SpaceTeam/STS1_EDU_Hardware/README.md

# STS1_EDU_Hardware
 Contains all Hardware Informations from EDU 2.6 onwards
