SpaceTeam/STS1_EDU_Hardware/STS1_EDU_V2_7/STS1_EDU_V2_7.kicad_pcb

## KiCad design STS1_EDU_V2_7/STS1_EDU_V2_7.kicad_pcb (2024-02-10)

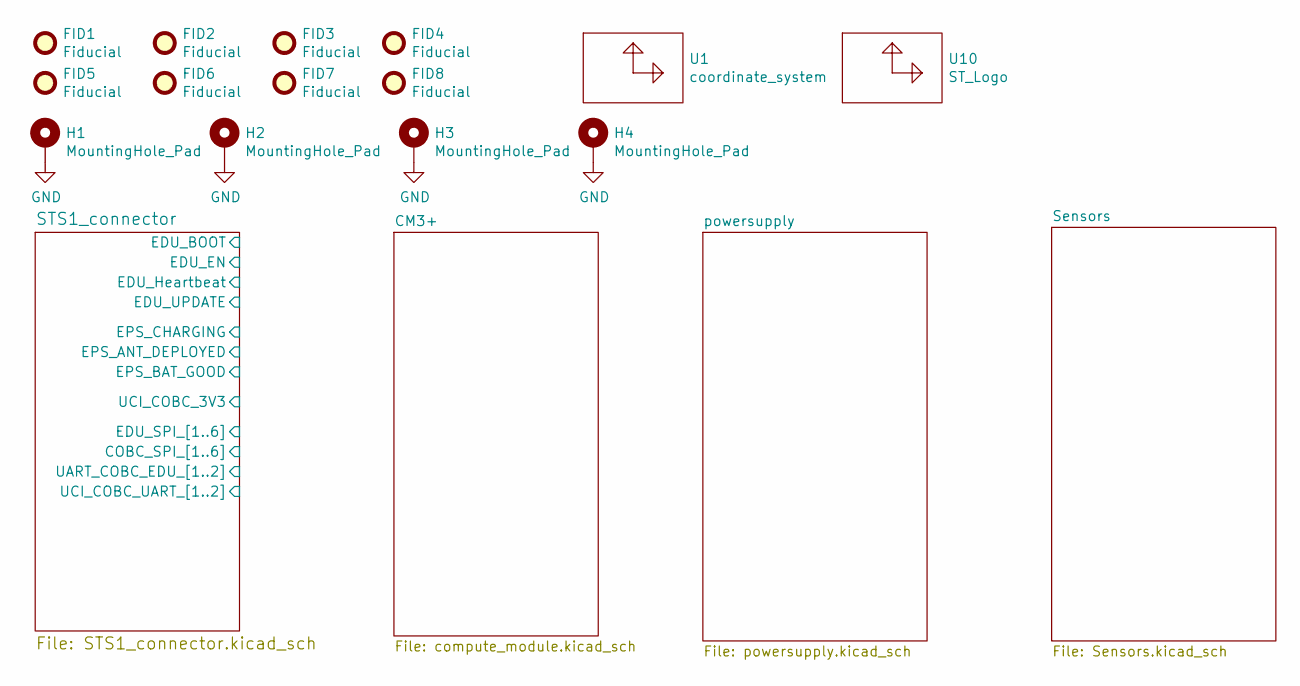
[picture p1: schematic STS1_EDU_V2_7.kicad_sch, STS1 template]

Parts:
FID1, FID2, FID3, FID4, FID5, FID6, FID7, FID8: Fiducial; Fiducial_0.75mm_Mask1.5mm
H1, H2, H3, H4: MountingHole_Pad; MountingHole_4.3mm_M4_Pad_Via
U1: coordinate_system; Coordinates
U10: ST_Logo; STLogo_7x8

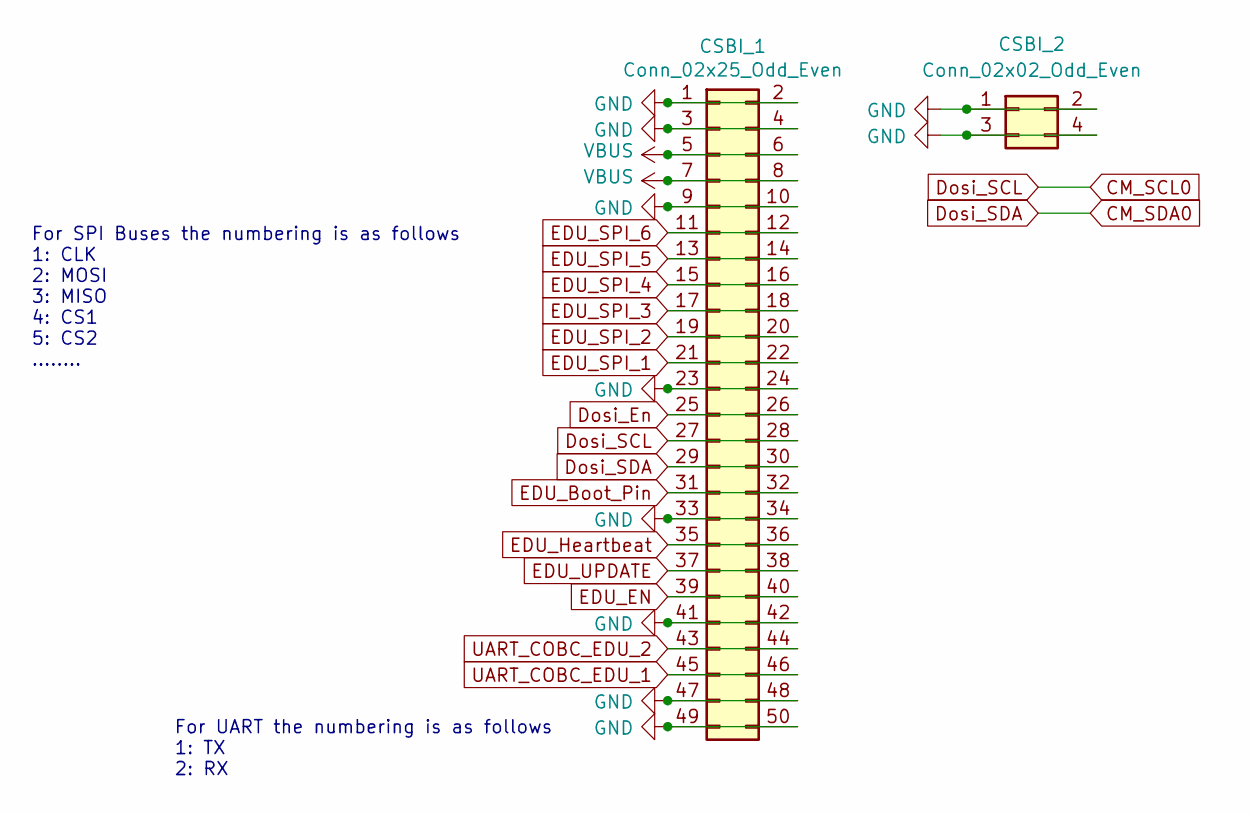
[picture p2: schematic STS1_connector.kicad_sch, STS1_connectors]

Parts:
CSBI_1: Conn_02x25_Odd_Even; PinHeader_2x25_P2.00mm_Vertical
CSBI_2: Conn_02x02_Odd_Even; PinHeader_2x02_P2.00mm_Vertical

Connections:
CM_SCL0: CSBI_1.27, CSBI_1.28; also elsewhere on the board
CM_SDA0: CSBI_1.29, CSBI_1.30; also elsewhere on the board
Dosi_En: CSBI_1.25, CSBI_1.26; also elsewhere on the board
EDU_Boot_Pin: CSBI_1.31, CSBI_1.32; also elsewhere on the board
EDU_EN: CSBI_1.39, CSBI_1.40; also elsewhere on the board
EDU_Heartbeat: CSBI_1.35, CSBI_1.36; also elsewhere on the board
EDU_SPI_1: CSBI_1.21, CSBI_1.22; also elsewhere on the board
EDU_SPI_2: CSBI_1.19, CSBI_1.20; also elsewhere on the board
EDU_SPI_3: CSBI_1.17, CSBI_1.18; also elsewhere on the board
EDU_SPI_4: CSBI_1.15, CSBI_1.16; also elsewhere on the board
EDU_SPI_5: CSBI_1.13, CSBI_1.14; also elsewhere on the board
EDU_SPI_6: CSBI_1.11, CSBI_1.12; also elsewhere on the board
EDU_UPDATE: CSBI_1.37, CSBI_1.38; also elsewhere on the board
UART_COBC_EDU_1: CSBI_1.45, CSBI_1.46
UART_COBC_EDU_2: CSBI_1.43, CSBI_1.44
VBUS: CSBI_1.5, CSBI_1.6, CSBI_1.7, CSBI_1.8; also elsewhere on the board

Notes on the sheet:
For SPI Buses the numbering is as follows 1: CLK 2: MOSI 3: MISO 4: CS1 5: CS2 ........
For UART the numbering is as follows 1: TX 2: RX

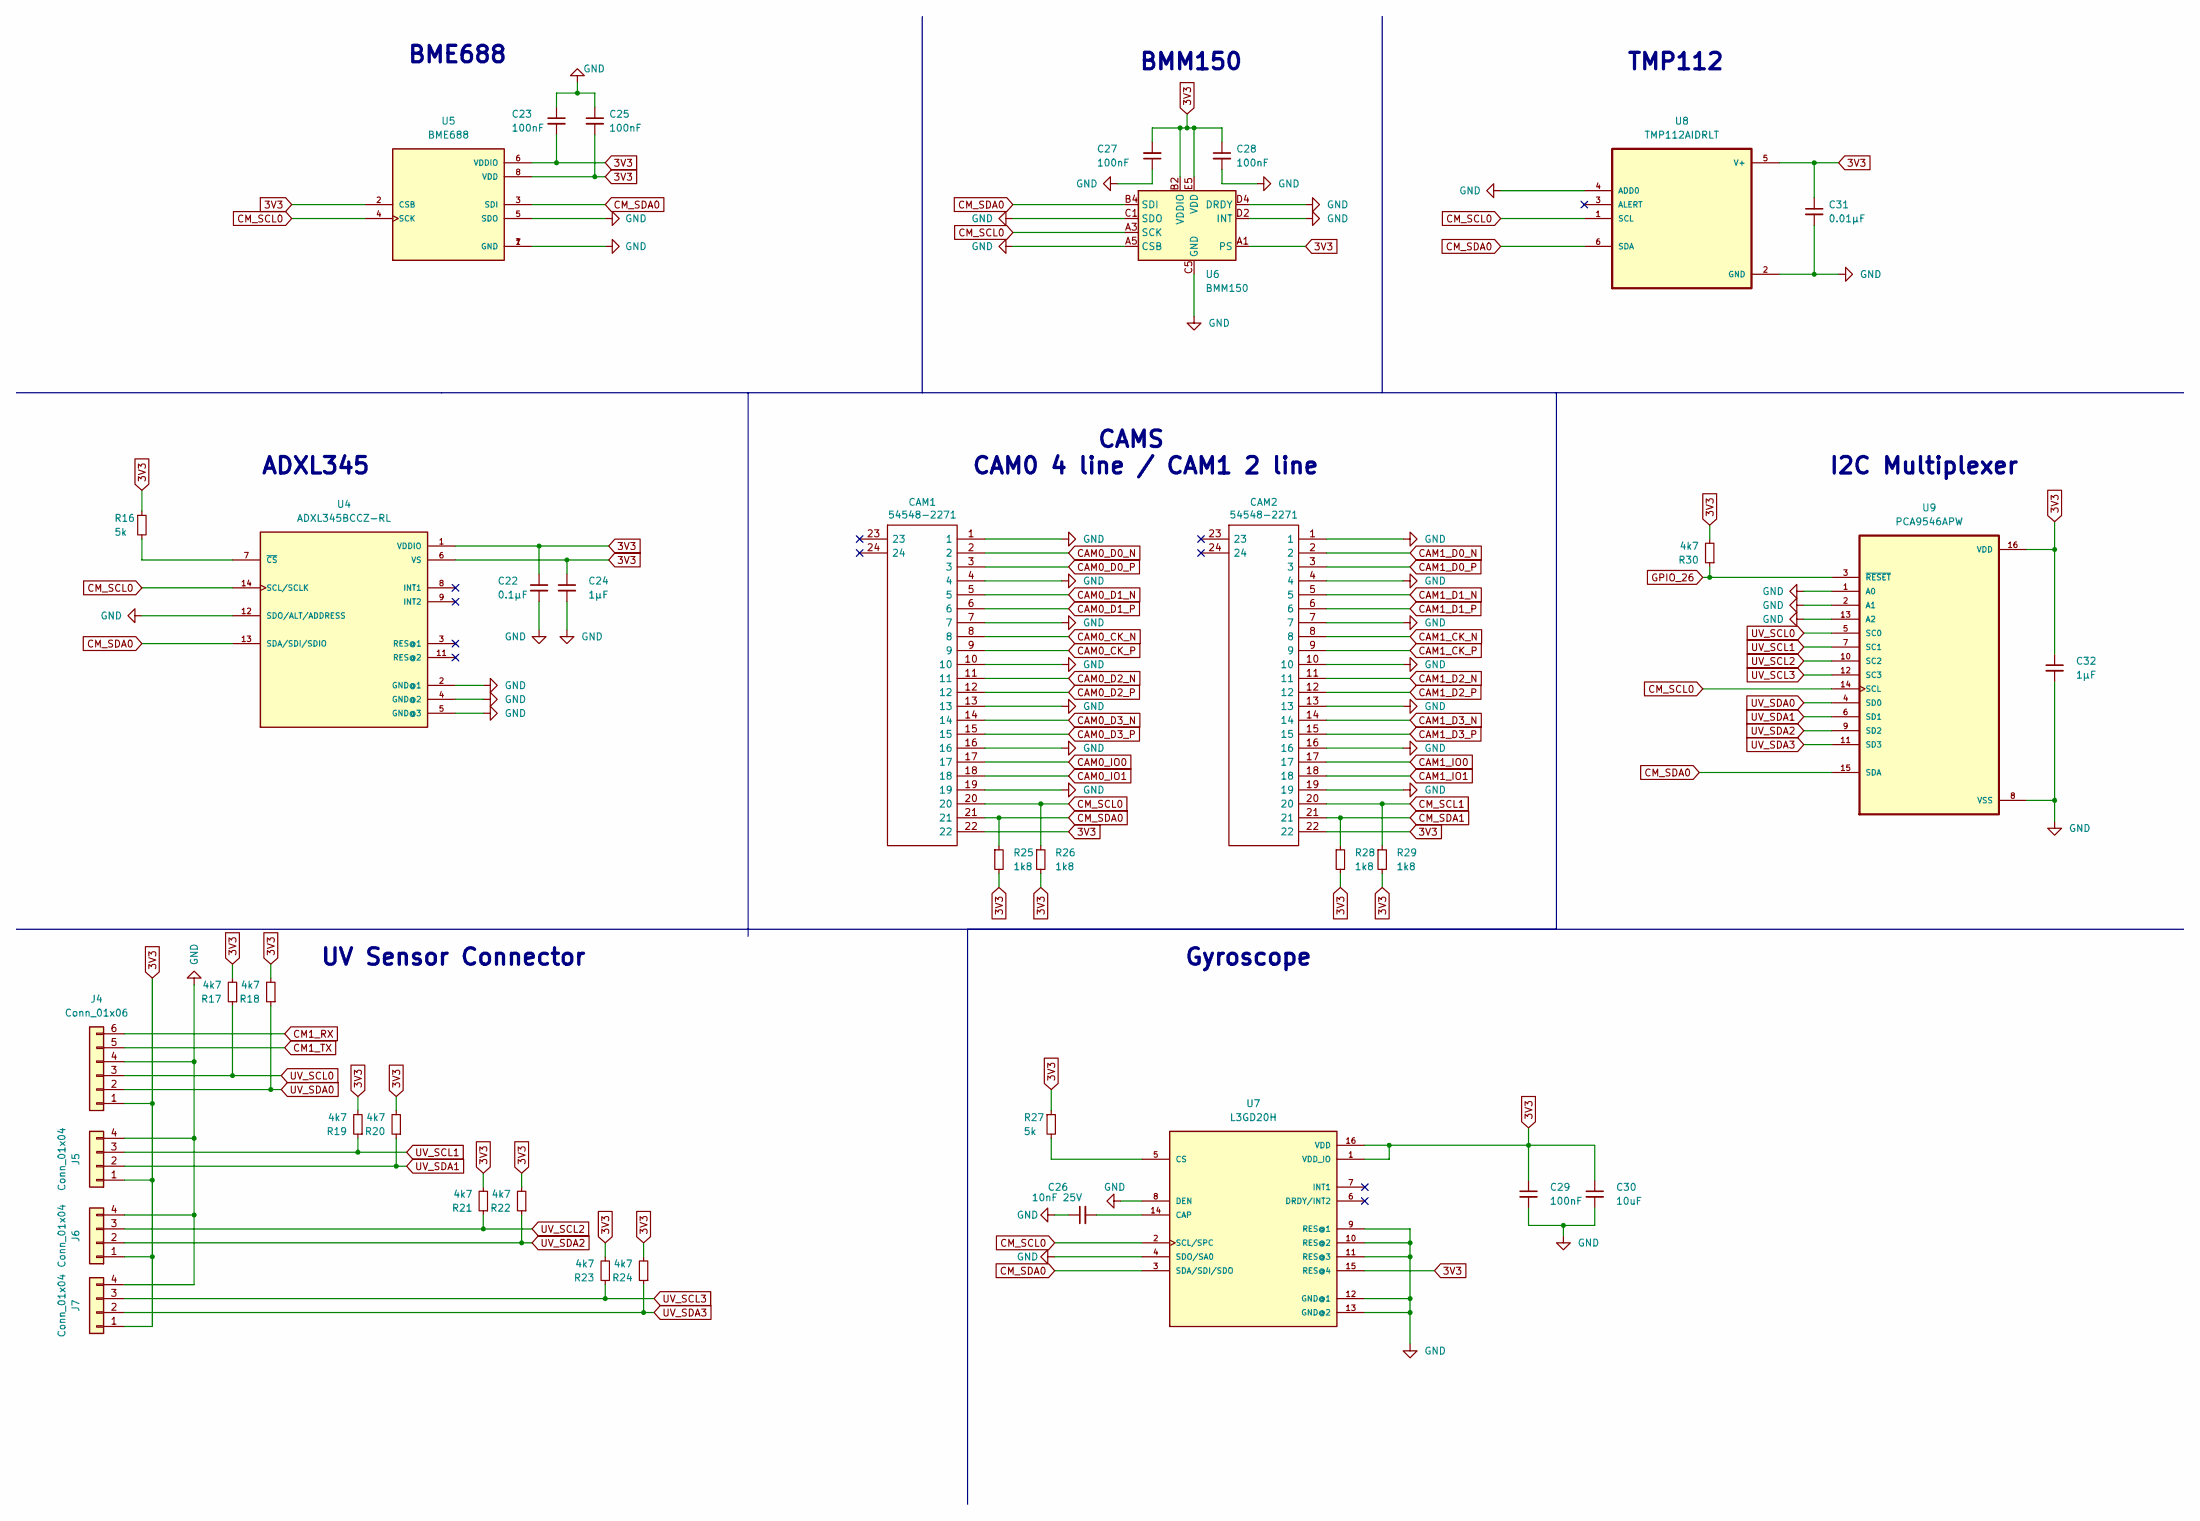
[picture p3: schematic Sensors.kicad_sch]

Parts:
C22: 0.1µF; C_0603_1608Metric_Pad1.08x0.95mm_HandSolder
C23, C25, C27, C28, C29: 100nF; C_0603_1608Metric_Pad1.08x0.95mm_HandSolder
C24, C32: 1µF; C_0603_1608Metric_Pad1.08x0.95mm_HandSolder
C26: 10nF 25V; C_0603_1608Metric_Pad1.08x0.95mm_HandSolder
C30: 10uF; C_0603_1608Metric_Pad1.08x0.95mm_HandSolder
C31: 0.01µF; C_0603_1608Metric_Pad1.08x0.95mm_HandSolder
CAM1, CAM2: 54548-2271; 545482271; Manufacturer_Part_Number 54548-2271; Mouser Part Number 538-54548-2271
J4: Conn_01x06; Molex_200528-0060_1x06-1MP_P1.00mm_Horizontal
J5, J6, J7: Conn_01x04; Molex_200528-0040_1x04-1MP_P1.00mm_Horizontal
R16, R27: 5k; R_0603_1608Metric_Pad0.98x0.95mm_HandSolder
R17, R18, R19, R20, R21, R22, R23, R24, R30: 4k7; R_0603_1608Metric_Pad0.98x0.95mm_HandSolder
R25, R26, R28, R29: 1k8; R_0603_1608Metric_Pad0.98x0.95mm_HandSolder
U4: ADXL345BCCZ-RL; LGA-14_3x5mm_P0.8mm_LayoutBorder1x6y
U5: BME688; Bosch_LGA-8_3x3mm_P0.8mm_ClockwisePinNumbering; PARTREV 1.0
U6: BMM150; WLCSP-12_1.56x1.56mm_P0.4mm
U7: L3GD20H; LGA-16_3x3mm_P0.5mm_LayoutBorder3x5y
U8: TMP112AIDRLT; SOT-563
U9: PCA9546APW; TSSOP-16_4.4x5mm_P0.65mm

Connections:
3V3: C22.1, C23.2, C24.1, C25.2, C27.2, C28.1, C29.1, C30.1, C31.1, C32.1, CAM1.22, CAM2.22, J4.1, J5.1, J6.1, J7.1, R16.1, R17.2, R18.2, R19.2, R20.2, R21.2, R22.2, R23.2, R24.2, R25.2, R26.2, R27.1, R28.2, R29.2, R30.2, U4.1 (VDDIO), U4.6 (VS), U5.2 (CSB), U5.6 (VDDIO), U5.8 (VDD), U6.A1 (PS), U6.B2 (VDDIO), U6.E5 (VDD), U7.1 (VDD_IO), U7.15 (RES@4), U7.16 (VDD), U8.5 (V+), U9.16 (VDD); also elsewhere on the board
CAM0_CK_N: CAM1.8; also elsewhere on the board
CAM0_CK_P: CAM1.9; also elsewhere on the board
CAM0_D0_N: CAM1.2; also elsewhere on the board
CAM0_D0_P: CAM1.3; also elsewhere on the board
CAM0_D1_N: CAM1.5; also elsewhere on the board
CAM0_D1_P: CAM1.6; also elsewhere on the board
CAM0_D2_N: CAM1.11
CAM0_D2_P: CAM1.12
CAM0_D3_N: CAM1.14
CAM0_D3_P: CAM1.15
CAM0_IO0: CAM1.17; also elsewhere on the board
CAM0_IO1: CAM1.18; also elsewhere on the board
CAM1_CK_N: CAM2.8; also elsewhere on the board
CAM1_CK_P: CAM2.9; also elsewhere on the board
CAM1_D0_N: CAM2.2; also elsewhere on the board
CAM1_D0_P: CAM2.3; also elsewhere on the board
CAM1_D1_N: CAM2.5; also elsewhere on the board
CAM1_D1_P: CAM2.6; also elsewhere on the board
CAM1_D2_N: CAM2.11; also elsewhere on the board
CAM1_D2_P: CAM2.12; also elsewhere on the board
CAM1_D3_N: CAM2.14; also elsewhere on the board
CAM1_D3_P: CAM2.15; also elsewhere on the board
CAM1_IO0: CAM2.17; also elsewhere on the board
CAM1_IO1: CAM2.18; also elsewhere on the board
CM1_RX: J4.6; also elsewhere on the board
CM1_TX: J4.5; also elsewhere on the board
CM_SCL0: CAM1.20, R26.1, U4.14 (SCL/SCLK), U5.4 (SCK), U6.A3 (SCK), U7.2 (SCL/SPC), U8.1 (SCL), U9.14 (SCL); also elsewhere on the board
CM_SCL1: CAM2.20, R29.1; also elsewhere on the board
CM_SDA0: CAM1.21, R25.1, U4.13 (SDA/SDI/SDIO), U5.3 (SDI), U6.B4 (SDI), U7.3 (SDA/SDI/SDO), U8.6 (SDA), U9.15 (SDA); also elsewhere on the board
CM_SDA1: CAM2.21, R28.1; also elsewhere on the board
GPIO_26: R30.1, U9.3 (~RESET); also elsewhere on the board
unnamed: R16.2, U4.7 (~CS)
unnamed: C26.2, U7.14 (CAP)
unnamed: R27.2, U7.5 (CS)
UV_SCL0: J4.3, R17.1, U9.5 (SC0)
UV_SCL1: J5.3, R19.1, U9.7 (SC1)
UV_SCL2: J6.3, R21.1, U9.10 (SC2)
UV_SCL3: J7.3, R23.1, U9.12 (SC3)
UV_SDA0: J4.2, R18.1, U9.4 (SD0)
UV_SDA1: J5.2, R20.1, U9.6 (SD1)
UV_SDA2: J6.2, R22.1, U9.9 (SD2)
UV_SDA3: J7.2, R24.1, U9.11 (SD3)

Notes on the sheet:
Gyroscope
BME688
CAMS CAM0 4 line / CAM1 2 line
I2C Multiplexer
ADXL345
UV Sensor Connector
TMP112
BMM150

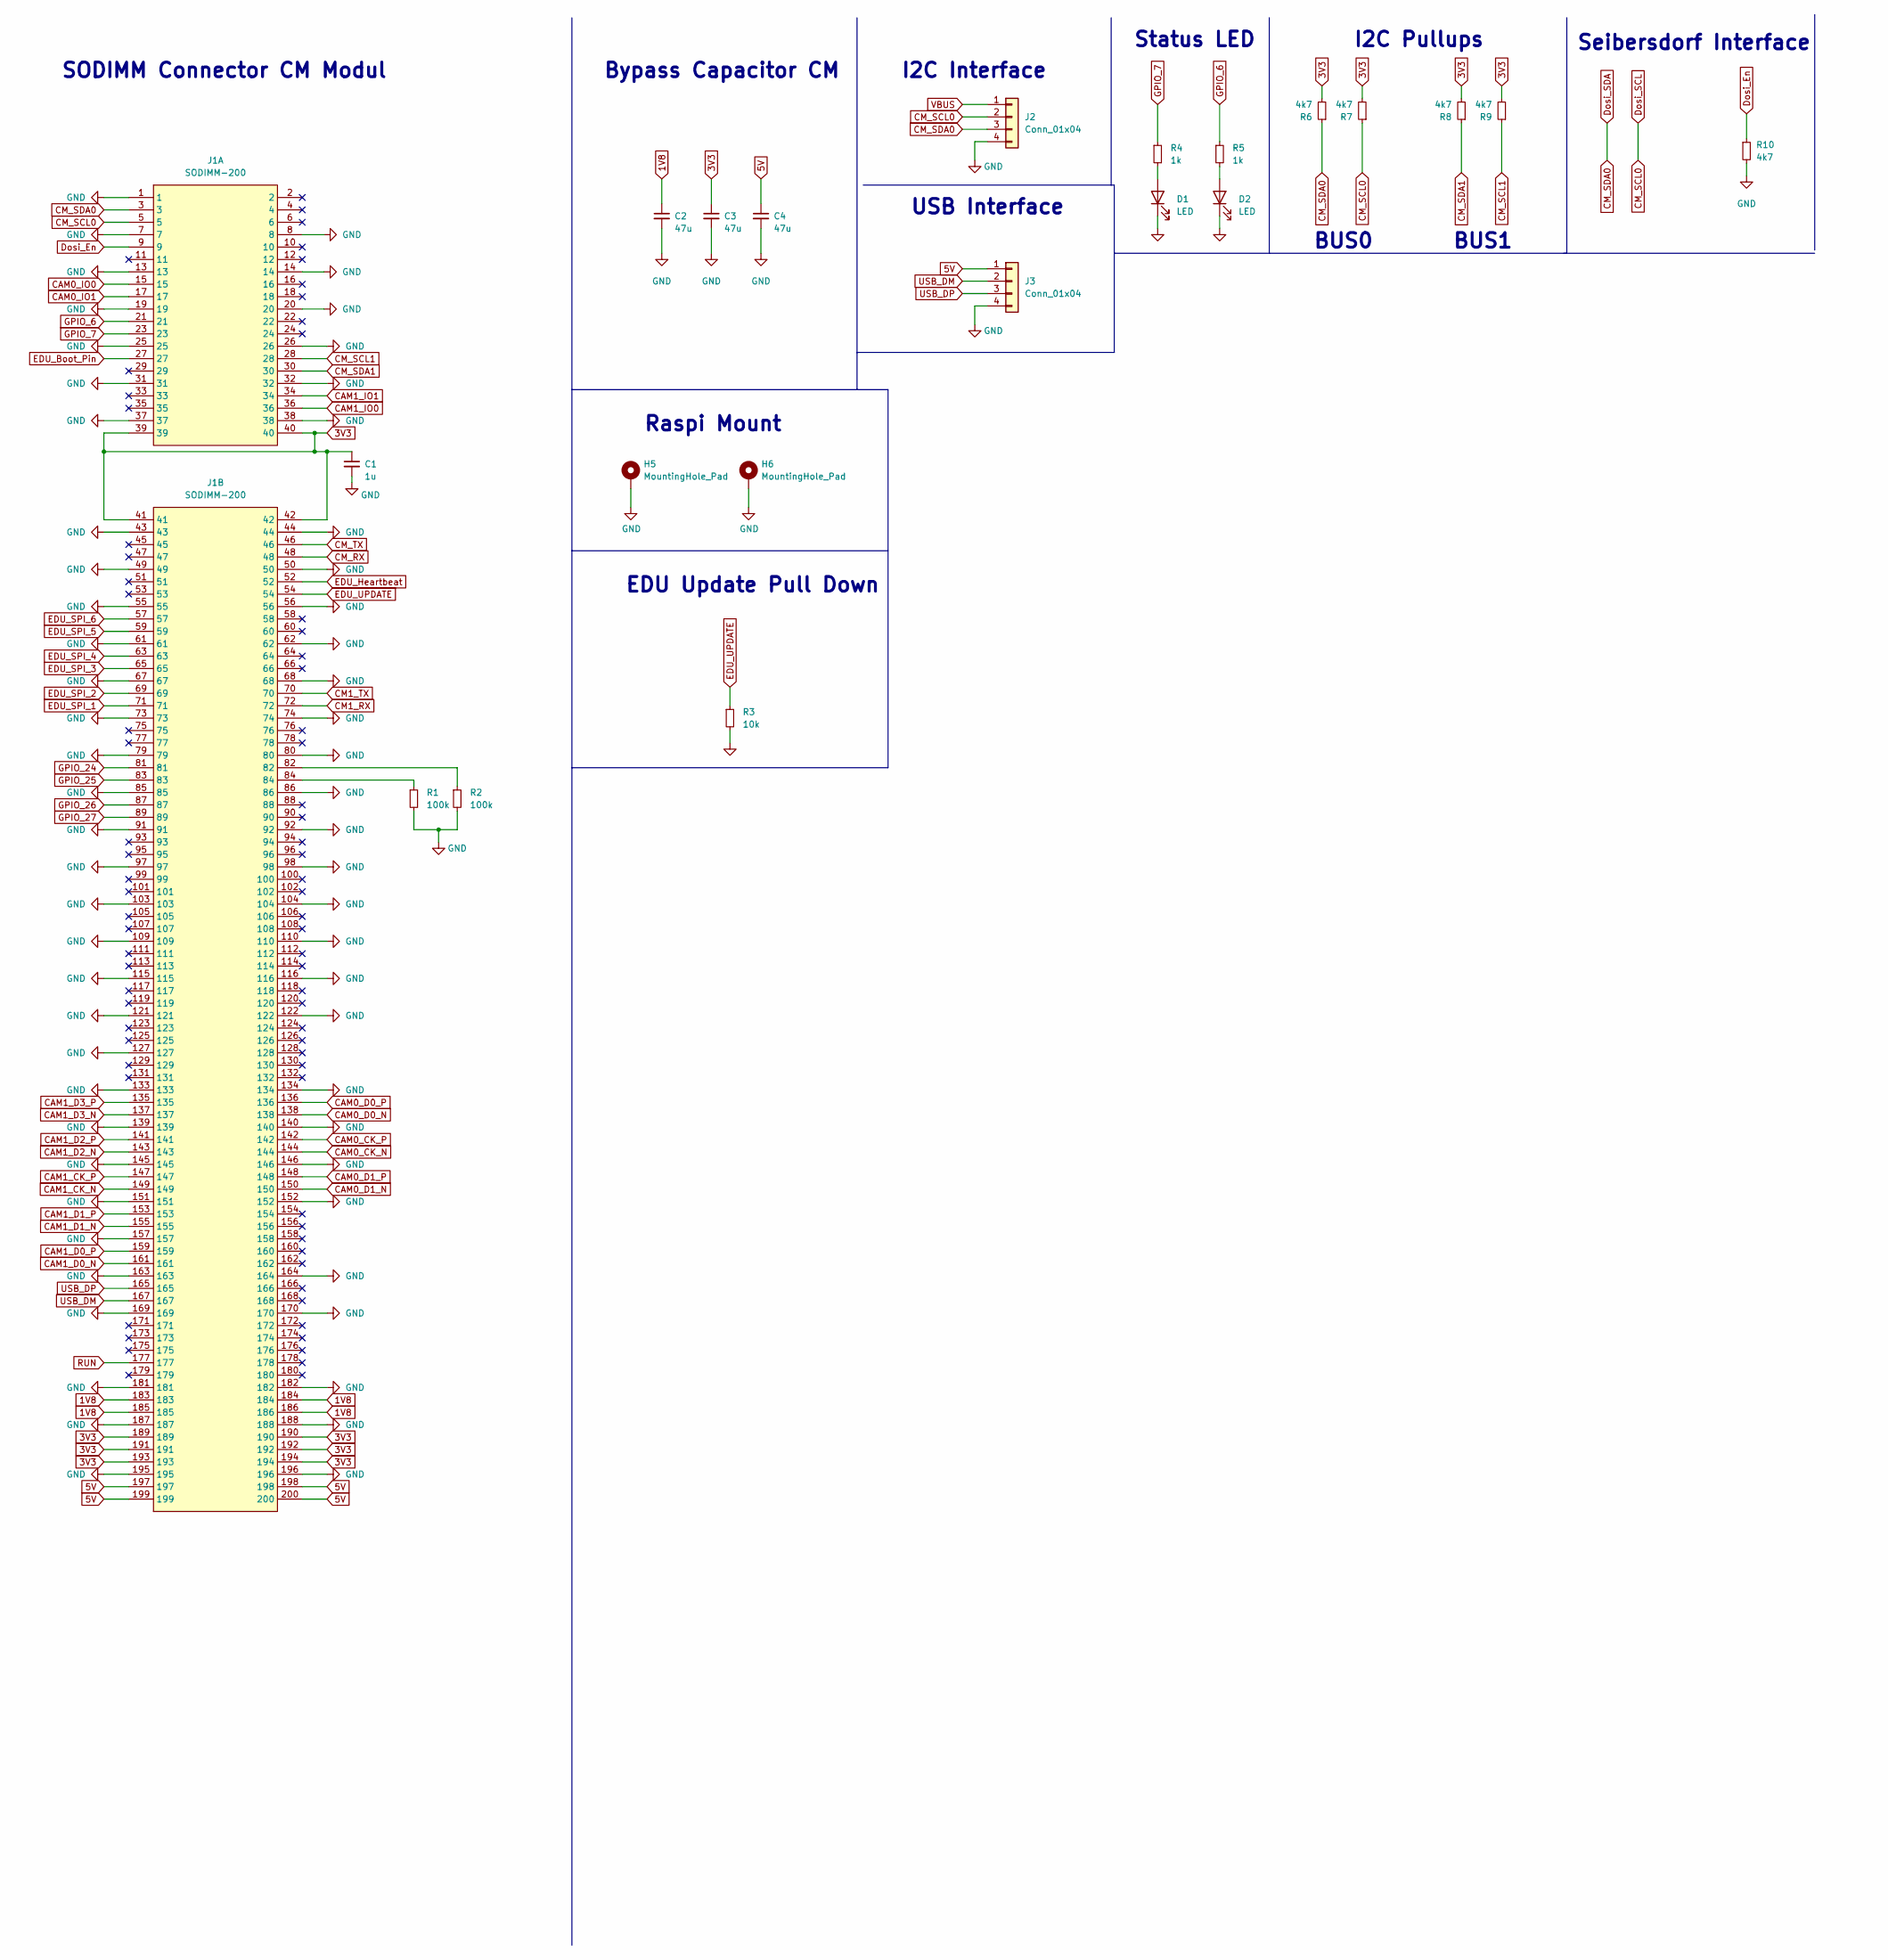
[picture p4: schematic compute_module.kicad_sch]

Parts:
C1: 1u; C_0603_1608Metric_Pad1.08x0.95mm_HandSolder
C2, C3, C4: 47u; C_0603_1608Metric_Pad1.08x0.95mm_HandSolder
D1, D2: LED; LED_0603_1608Metric_Pad1.05x0.95mm_HandSolder
H5, H6: MountingHole_Pad; MountingHole_2.2mm_M2_Pad_Via
J1: SODIMM-200; 17172544
J2, J3: Conn_01x04; PinHeader_1x04_P2.54mm_Vertical
R1, R2: 100k; R_0603_1608Metric_Pad0.98x0.95mm_HandSolder
R3: 10k; R_0603_1608Metric_Pad0.98x0.95mm_HandSolder
R4, R5: 1k; R_0603_1608Metric_Pad0.98x0.95mm_HandSolder
R6, R7, R8, R9, R10: 4k7; R_0603_1608Metric_Pad0.98x0.95mm_HandSolder

Connections:
1V8: C2.1, J1.183, J1.184, J1.185, J1.186; also elsewhere on the board
3V3: C1.1, C3.1, J1.39, J1.40, J1.41, J1.42, J1.189, J1.190, J1.191, J1.192, J1.193, J1.194, R6.2, R7.2, R8.2, R9.2; also elsewhere on the board
5V: C4.1, J1.197, J1.198, J1.199, J1.200, J3.1; also elsewhere on the board
CAM0_CK_N: J1.144; also elsewhere on the board
CAM0_CK_P: J1.142; also elsewhere on the board
CAM0_D0_N: J1.138; also elsewhere on the board
CAM0_D0_P: J1.136; also elsewhere on the board
CAM0_D1_N: J1.150; also elsewhere on the board
CAM0_D1_P: J1.148; also elsewhere on the board
CAM0_IO0: J1.15; also elsewhere on the board
CAM0_IO1: J1.17; also elsewhere on the board
CAM1_CK_N: J1.149; also elsewhere on the board
CAM1_CK_P: J1.147; also elsewhere on the board
CAM1_D0_N: J1.161; also elsewhere on the board
CAM1_D0_P: J1.159; also elsewhere on the board
CAM1_D1_N: J1.155; also elsewhere on the board
CAM1_D1_P: J1.153; also elsewhere on the board
CAM1_D2_N: J1.143; also elsewhere on the board
CAM1_D2_P: J1.141; also elsewhere on the board
CAM1_D3_N: J1.137; also elsewhere on the board
CAM1_D3_P: J1.135; also elsewhere on the board
CAM1_IO0: J1.36; also elsewhere on the board
CAM1_IO1: J1.34; also elsewhere on the board
CM1_RX: J1.72; also elsewhere on the board
CM1_TX: J1.70; also elsewhere on the board
CM_RX: J1.48
CM_SCL0: J1.5, J2.2, R7.1; also elsewhere on the board
CM_SCL1: J1.28, R9.1; also elsewhere on the board
CM_SDA0: J1.3, J2.3, R6.1; also elsewhere on the board
CM_SDA1: J1.30, R8.1; also elsewhere on the board
CM_TX: J1.46
Dosi_En: J1.9, R10.1; also elsewhere on the board
EDU_Boot_Pin: J1.27; also elsewhere on the board
EDU_Heartbeat: J1.52; also elsewhere on the board
EDU_SPI_1: J1.71; also elsewhere on the board
EDU_SPI_2: J1.69; also elsewhere on the board
EDU_SPI_3: J1.65; also elsewhere on the board
EDU_SPI_4: J1.63; also elsewhere on the board
EDU_SPI_5: J1.59; also elsewhere on the board
EDU_SPI_6: J1.57; also elsewhere on the board
EDU_UPDATE: J1.54, R3.1; also elsewhere on the board
GPIO_6: J1.21, R5.1
GPIO_7: J1.23, R4.1
GPIO_24: J1.81
GPIO_25: J1.83
GPIO_26: J1.87; also elsewhere on the board
GPIO_27: J1.89
unnamed: D1.2 (A), R4.2
unnamed: D2.2 (A), R5.2
unnamed: J1.82, R2.1
unnamed: J1.84, R1.1
RUN: J1.177
USB_DM: J1.167, J3.2
USB_DP: J1.165, J3.3
VBUS: J2.1; also elsewhere on the board

Notes on the sheet:
SODIMM Connector CM Modul
EDU Update Pull Down
Seibersdorf Interface
BUS0
Status LED
USB Interface
Raspi Mount
BUS1
I2C Pullups
Bypass Capacitor CM
I2C Interface

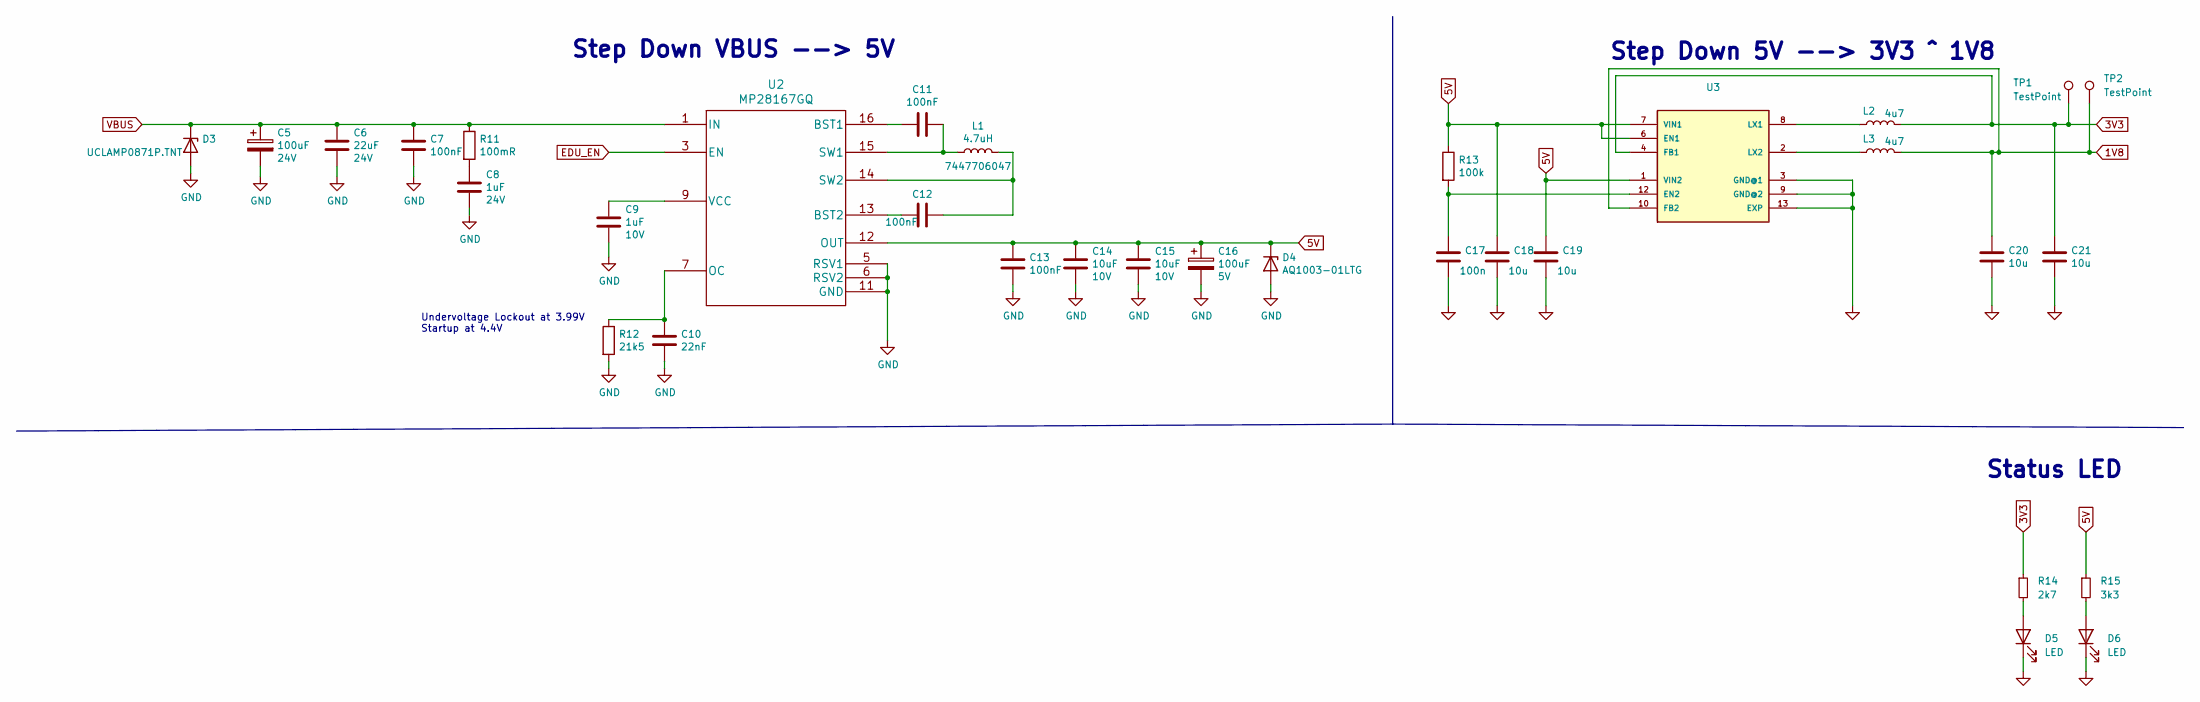
[picture p5: schematic powersupply.kicad_sch]

Parts:
C5: 100uF; CP_EIA-7343-43_Kemet-X; Voltage 24V
C6: 22uF; C_1206_3216Metric; Voltage 24V
C7, C11, C12, C13: 100nF; C_0603_1608Metric
C8: 1uF; C_0805_2012Metric; Voltage 24V
C9: 1uF; C_0805_2012Metric; Voltage 10V
C10: 22nF; C_0603_1608Metric
C14, C15: 10uF; C_0805_2012Metric; Voltage 10V
C16: 100uF; CP_EIA-7343-43_Kemet-X; Voltage 5V
C17: 100n; C_0603_1608Metric_Pad1.08x0.95mm_HandSolder
C18, C19, C20, C21: 10u; C_0603_1608Metric_Pad1.08x0.95mm_HandSolder
D3: UCLAMP0871P.TNT; SGP1610N2
D4: AQ1003-01LTG; D_SOD-523
D5, D6: LED; LED_0603_1608Metric_Pad1.05x0.95mm_HandSolder
L1: 4.7uH; L_12x12mm_H6mm; Part 7447706047
L2, L3: 4u7; L_1210_3225Metric_Pad1.42x2.65mm_HandSolder
R11: 100mR; R_0603_1608Metric
R12: 21k5; R_0603_1608Metric
R13: 100k; R_0603_1608Metric_Pad0.98x0.95mm_HandSolder
R14: 2k7; R_0603_1608Metric_Pad0.98x0.95mm_HandSolder
R15: 3k3; R_0603_1608Metric_Pad0.98x0.95mm_HandSolder
TP1, TP2: TestPoint; TestPoint_Pad_1.0x1.0mm
U2: MP28167GQ; MP28167_QFN16
U3: SON45P300X300X80-13N

Connections:
1V8: C20.1, L3.2, TP2.1, U3.10 (FB2); also elsewhere on the board
3V3: C21.1, L2.2, R14.1, TP1.1, U3.4 (FB1); also elsewhere on the board
5V: C13.1, C14.1, C15.1, C16.1, C18.1, C19.1, D4.1 (K), R13.1, R15.1, U2.12 (OUT), U3.1 (VIN2), U3.6 (EN1), U3.7 (VIN1); also elsewhere on the board
EDU_EN: U2.3 (EN); also elsewhere on the board
unnamed: C8.1, R11.2
unnamed: D5.2 (A), R14.2
unnamed: D6.2 (A), R15.2
unnamed: C11.2, U2.16 (BST1)
unnamed: C12.2, U2.13 (BST2)
unnamed: C10.1, R12.1, U2.7 (OC)
unnamed: C11.1, L1.1, U2.15 (SW1)
unnamed: C12.1, L1.2, U2.14 (SW2)
unnamed: C9.1, U2.9 (VCC)
unnamed: C17.1, R13.2, U3.12 (EN2)
unnamed: L2.1, U3.8 (LX1)
unnamed: L3.1, U3.2 (LX2)
VBUS: C5.1, C6.1, C7.1, D3.1 (K), R11.1, U2.1 (IN); also elsewhere on the board

Notes on the sheet:
Status LED
Step Down VBUS --> 5V
Undervoltage Lockout at 3.99V Startup at 4.4V
Step Down 5V --> 3V3 ^ 1V8

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
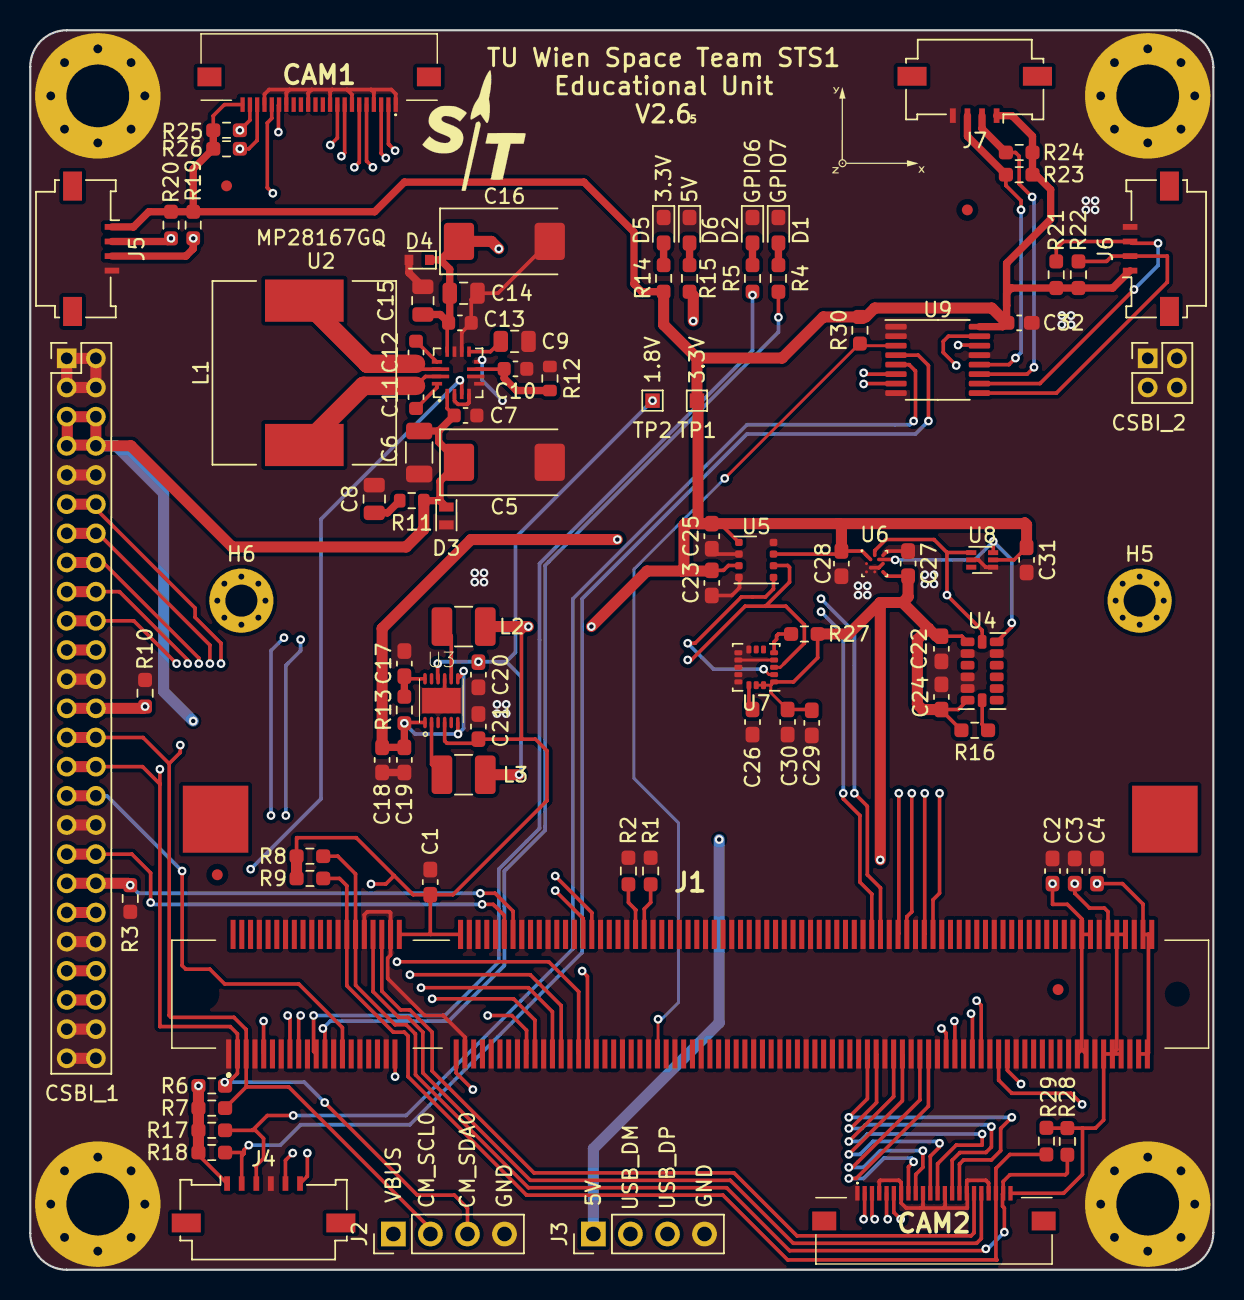
[picture p6: board STS1_EDU_V2_7.kicad_pcb from above]

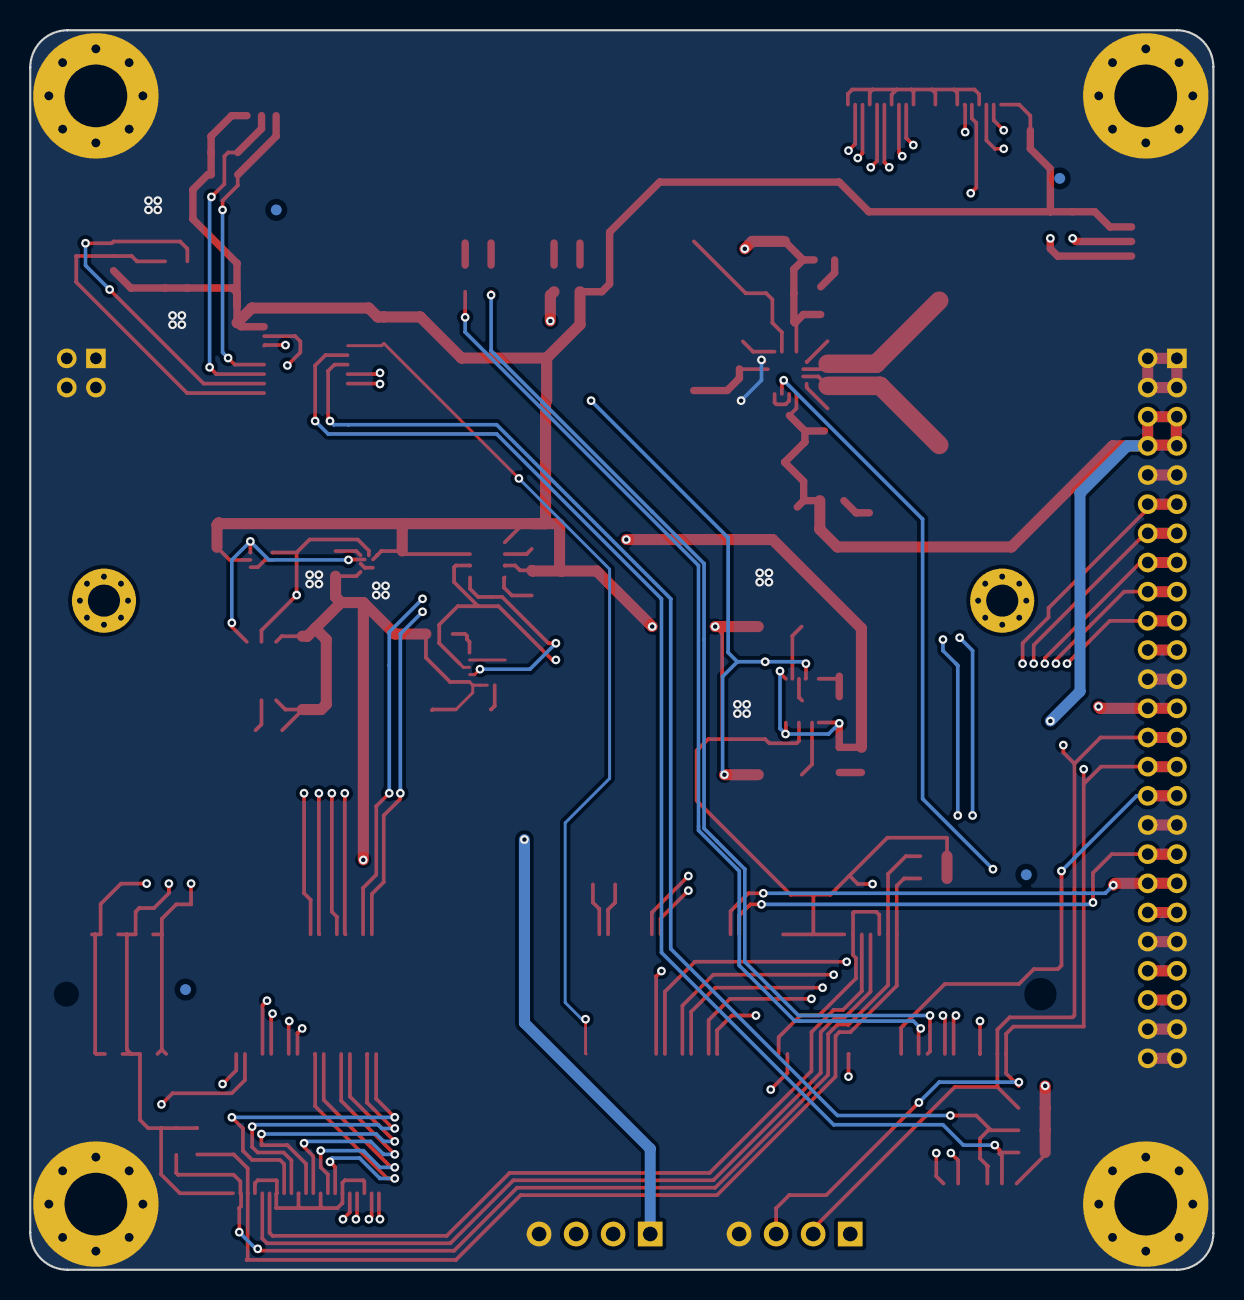
[picture p7: board STS1_EDU_V2_7.kicad_pcb from below]

Board: 4 copper layers, 81.1 x 85.0 mm, 108 parts (4 on the bottom side), 77 nets.
